averywallis/Feather-NEO-M9N-GPS/README.md

# Feather-NEO-M9N-GPS
 KiCad files for a NEO-M9N GPS Featherwing
