averywallis/Feather-NEO-M9N-GPS/Rev2.3/schematic-rev2.3.pdf

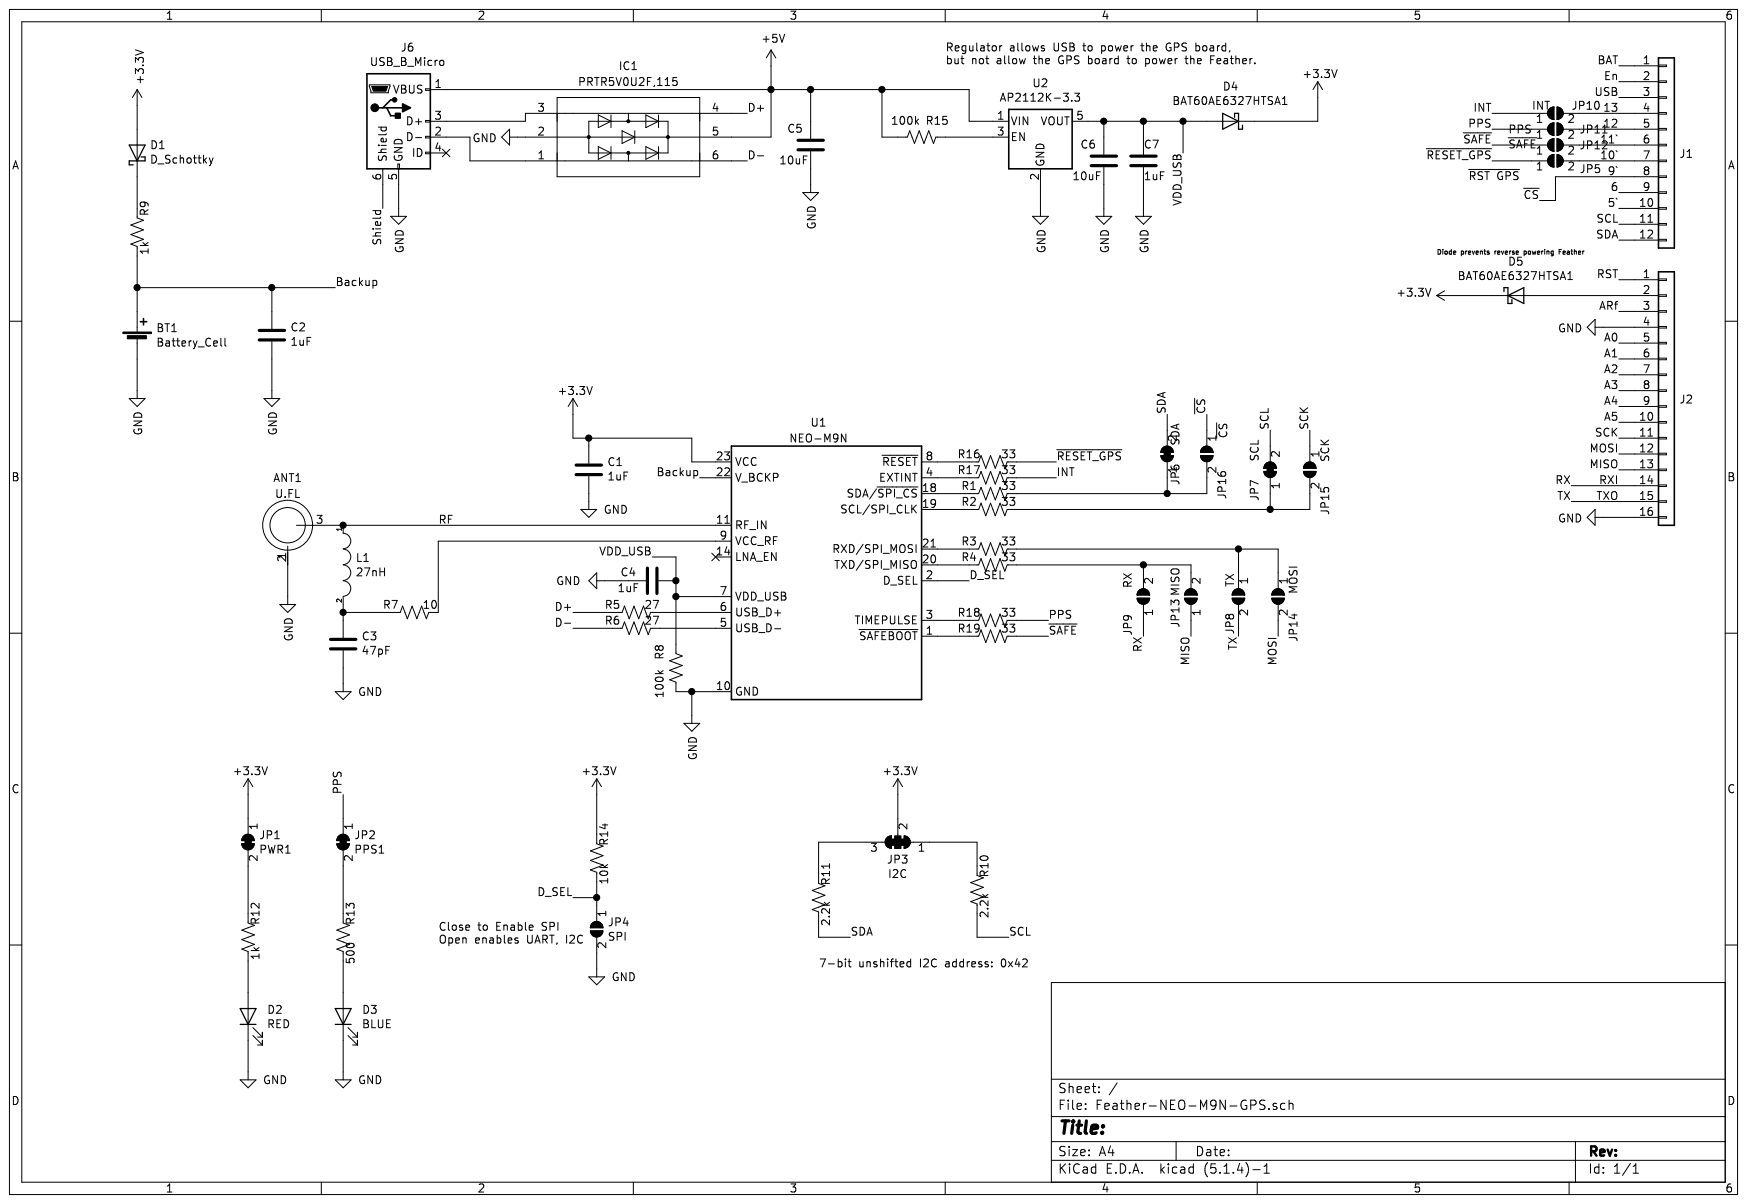
[picture p1: page 1]
