averywallis/Feather-NEO-M9N-GPS/Rev2.2/schematic.pdf

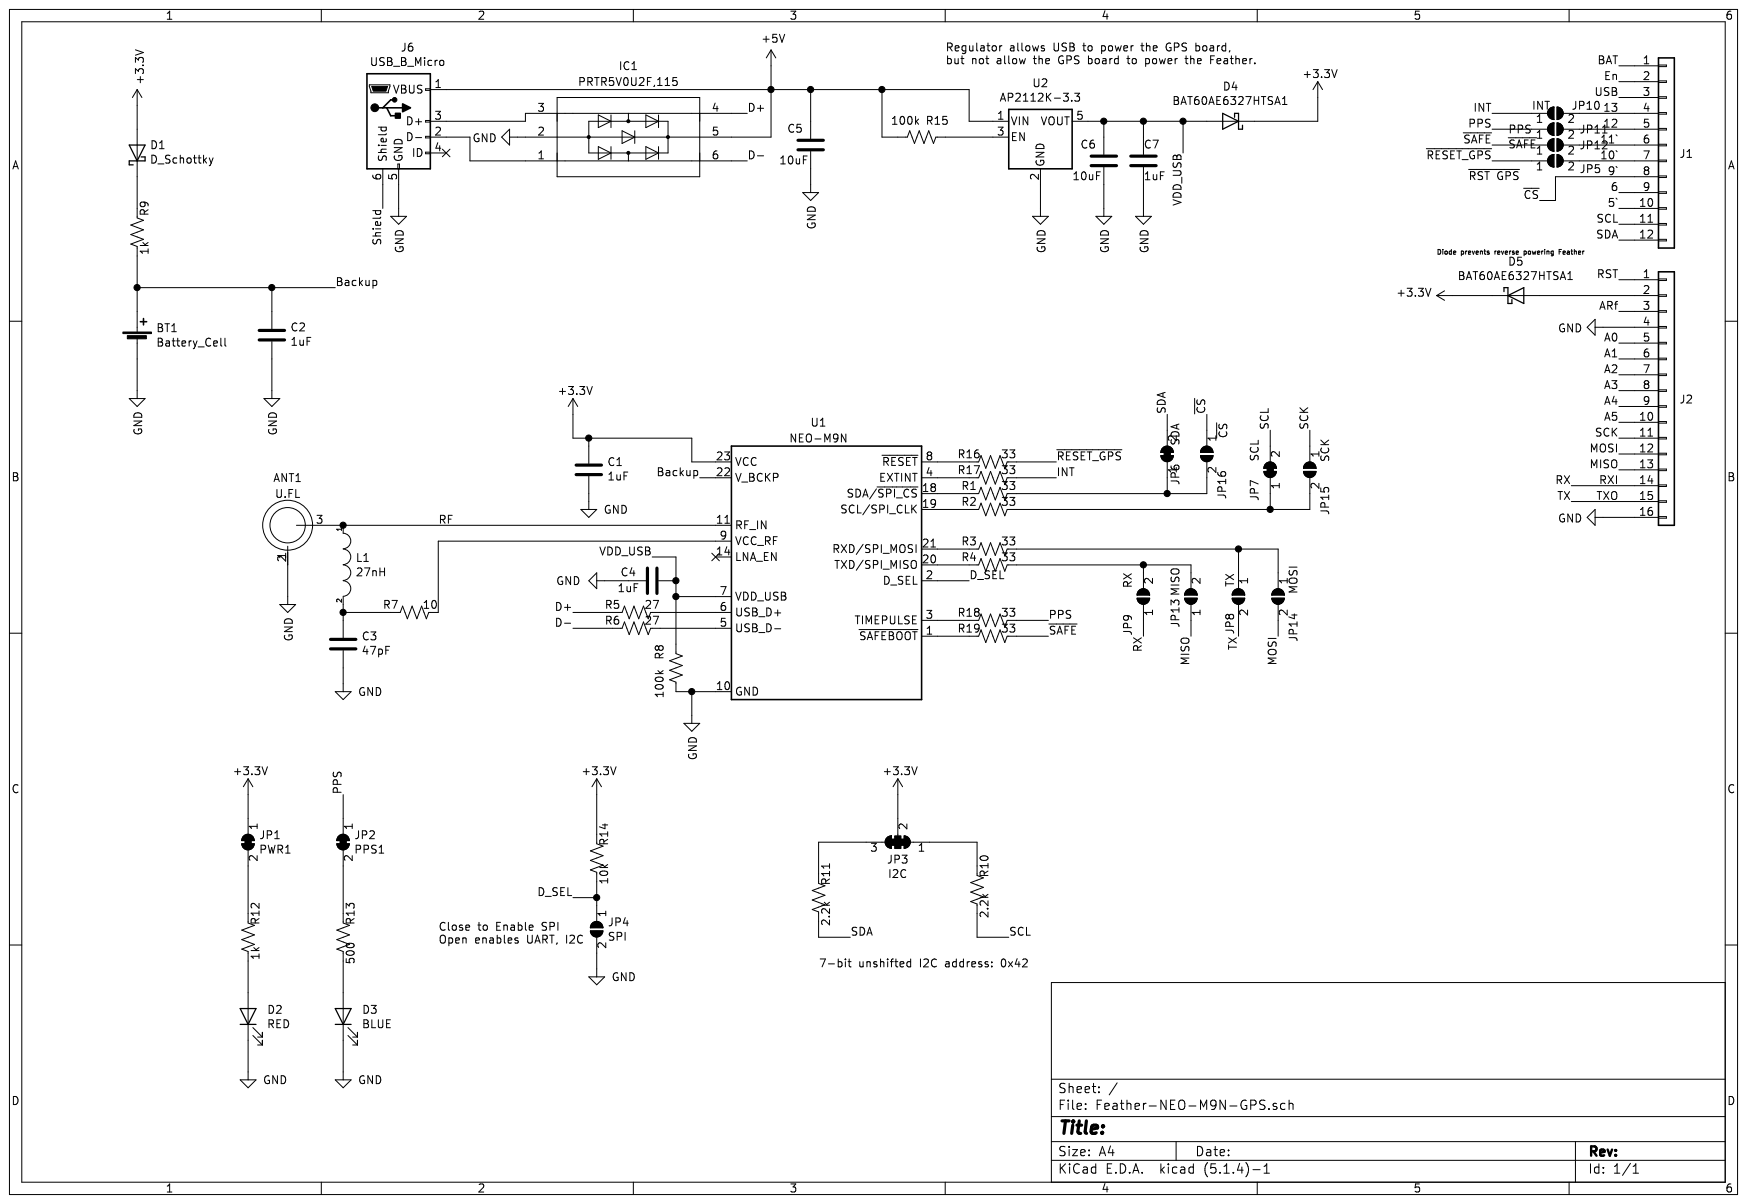
[picture p2: page 1]
