averywallis/Feather-NEO-M9N-GPS/Rev2/NEO-M9N-Rev2-Schematic.pdf

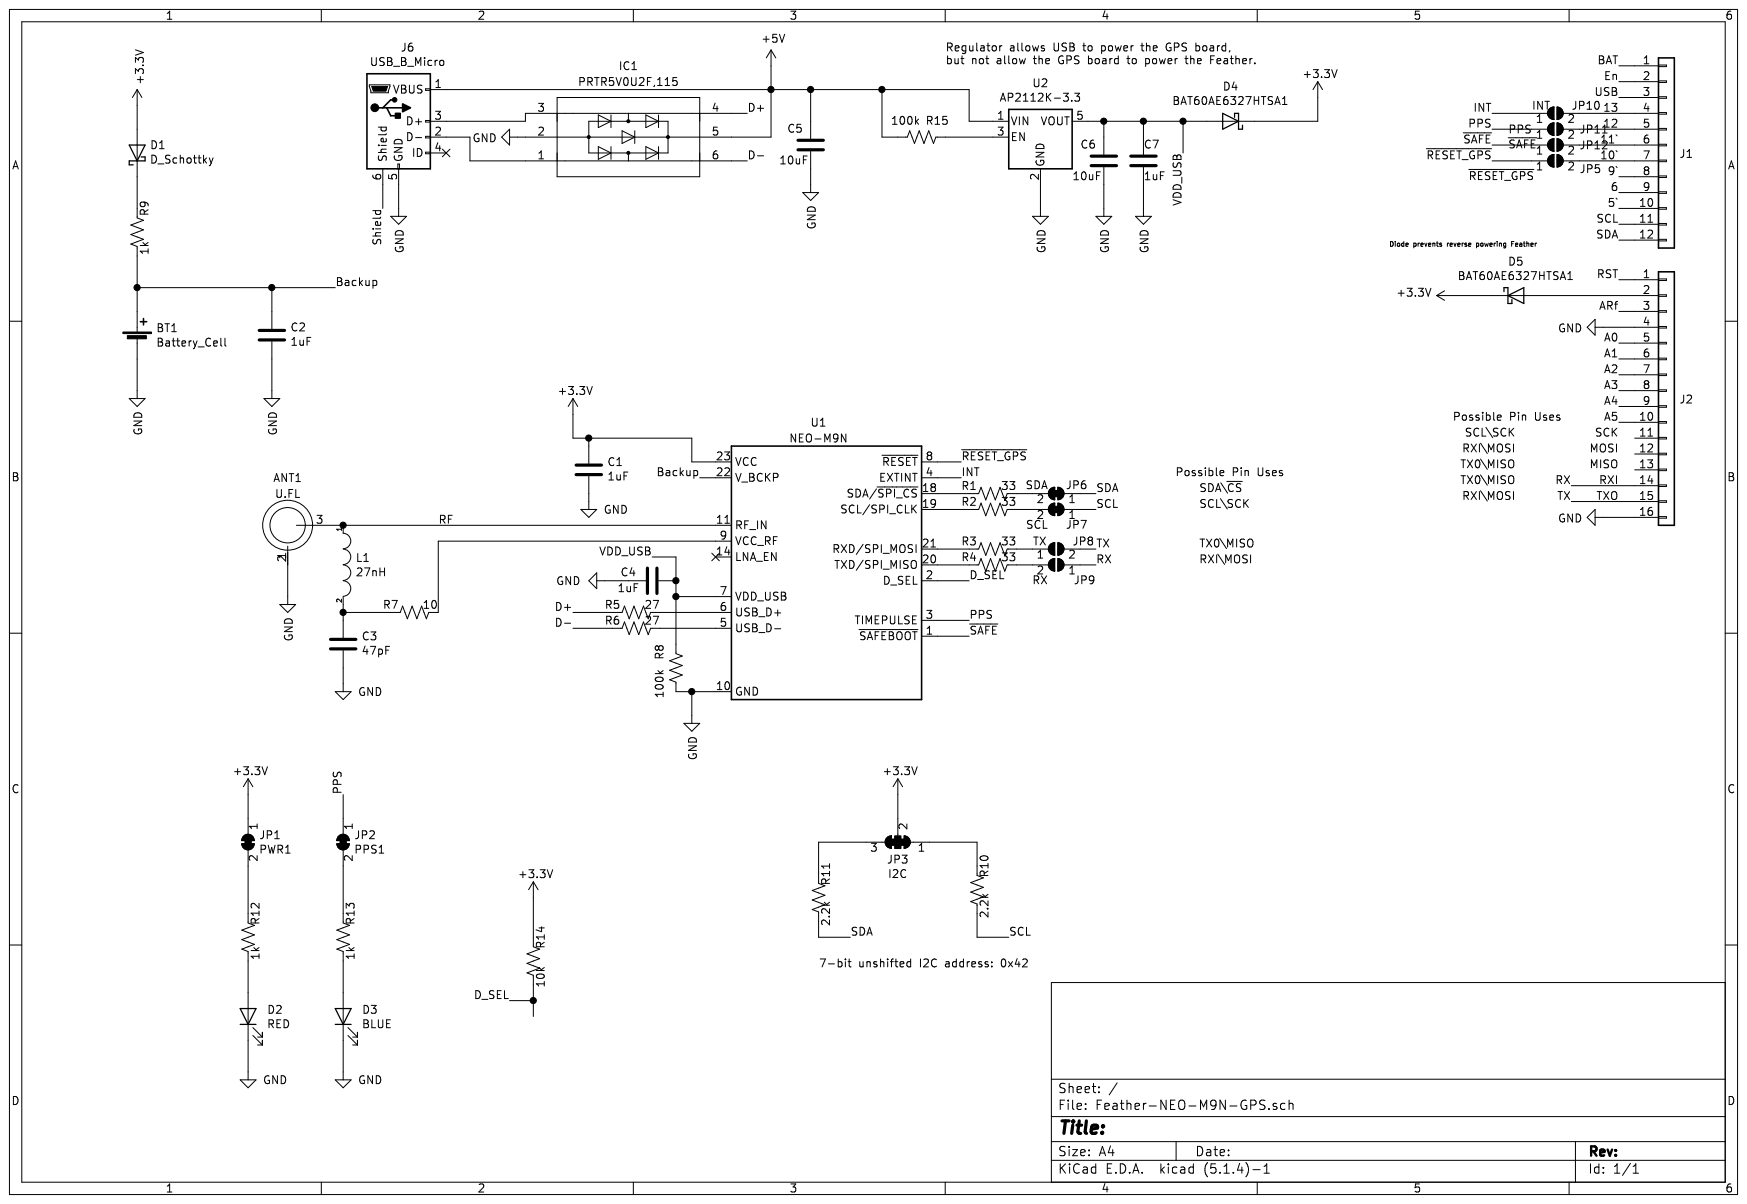
[picture p3: page 1]
