averywallis/Feather-NEO-M9N-GPS/Feather-NEO-M9N-GPS.kicad_pcb

## KiCad design Feather-NEO-M9N-GPS.kicad_pcb (2022-01-29)

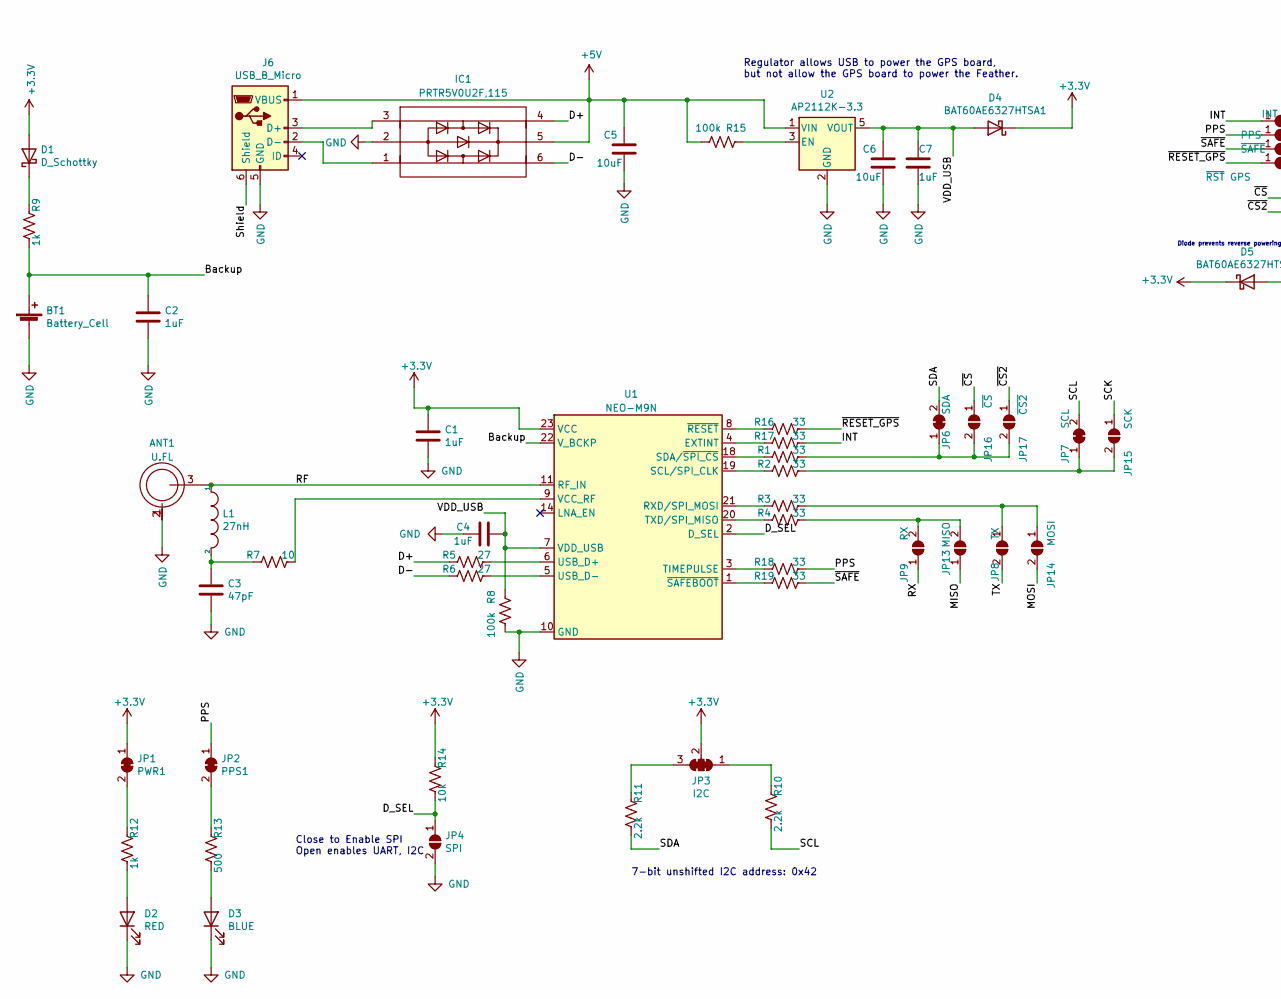
[picture p4: schematic Feather-NEO-M9N-GPS.sch, part in row 1, column 1]

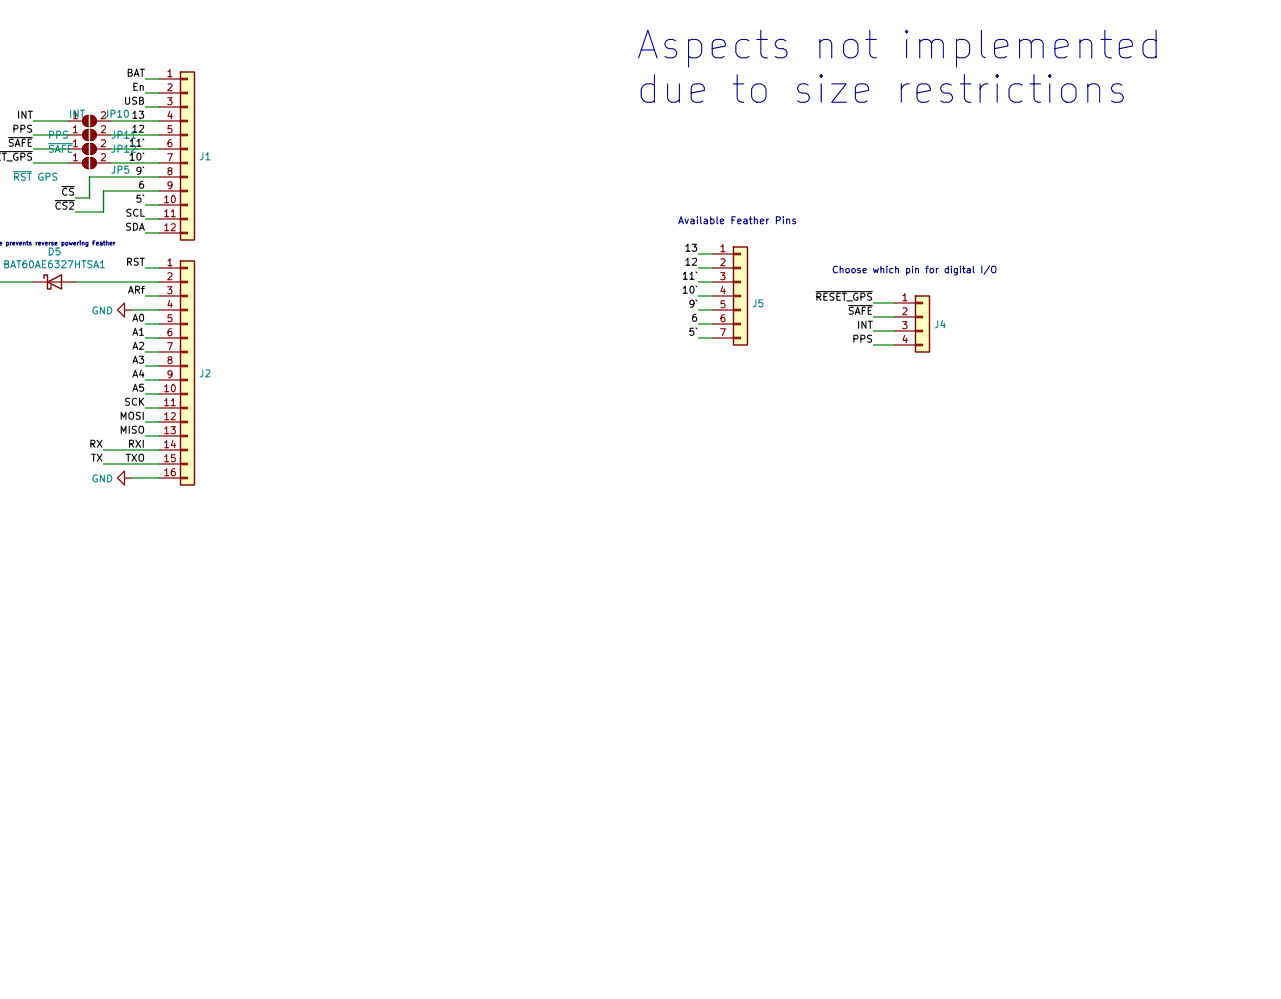
[picture p5: schematic Feather-NEO-M9N-GPS.sch, part in row 1, column 2]

Parts:
ANT1: U.FL; UFLRSMT10; MPN U.FL-R-SMT(10)
BT1: Battery_Cell; BatteryHolder_Seiko_MS621F; MPN MS621FE-FL11E
C1, C2, C4, C7: 1uF; C_0603_1608Metric; MPN CL10A105KA8NNNC
C3: 47pF; C_0603_1608Metric; MPN GRM1885C1H470FA01J
C5, C6: 10uF; C_0603_1608Metric; MPN GRM188R61C106KAALD
D1: D_Schottky; D_SOD-323F; MPN PMEG4005EJF
D2: RED; LED_0603_1608Metric; MPN SML-D12V8WT86
D3: BLUE; LED_0603_1608Metric; MPN 598-8091-107F
D4, D5: BAT60AE6327HTSA1; SOD2513X110N; MPN BAT60AE6327HTSA1
IC1: PRTR5V0U2F,115; 74LVC1G27GM115; MPN PRTR5V0U2F,115
J1: PinHeader_1x12_P2.54mm_Vertical
J2: PinHeader_1x16_P2.54mm_Vertical
J4: PinHeader_1x04_P2.54mm_Vertical
J5: PinHeader_1x07_P2.54mm_Vertical
J6: USB_B_Micro; USB_Micro-B_Molex_47346-0001; MPN 47346-0001
JP1: PWR1; SolderJumper-2_P1.3mm_Bridged_RoundedPad1.0x1.5mm
JP2: PPS1; SolderJumper-2_P1.3mm_Bridged_RoundedPad1.0x1.5mm
JP3: I2C; SMT-JUMPER_3_2-NC_TRACE_SILK
JP4: SPI; SolderJumper-2_P1.3mm_Open_RoundedPad1.0x1.5mm
JP5: ~RST GPS; SolderJumper-2_P1.3mm_Open_RoundedPad1.0x1.5mm
JP6: SDA; SolderJumper-2_P1.3mm_Bridged_RoundedPad1.0x1.5mm
JP7: SCL; SolderJumper-2_P1.3mm_Bridged_RoundedPad1.0x1.5mm
JP8: TX; SolderJumper-2_P1.3mm_Open_RoundedPad1.0x1.5mm
JP9: RX; SolderJumper-2_P1.3mm_Open_RoundedPad1.0x1.5mm
JP10: INT; SolderJumper-2_P1.3mm_Open_RoundedPad1.0x1.5mm
JP11: PPS; SolderJumper-2_P1.3mm_Open_RoundedPad1.0x1.5mm
JP12: ~SAFE; SolderJumper-2_P1.3mm_Open_RoundedPad1.0x1.5mm
JP13: MISO; SolderJumper-2_P1.3mm_Open_RoundedPad1.0x1.5mm
JP14: MOSI; SolderJumper-2_P1.3mm_Open_RoundedPad1.0x1.5mm
JP15: SCK; SolderJumper-2_P1.3mm_Open_RoundedPad1.0x1.5mm
JP16: ~CS; SolderJumper-2_P1.3mm_Open_RoundedPad1.0x1.5mm
JP17: ~CS2; SolderJumper-2_P1.3mm_Open_RoundedPad1.0x1.5mm
L1: 27nH; L_0805_2012Metric; MPN CE201210-27NJ
R1, R2, R3, R4, R16, R17, R18, R19: 33; R_0402_1005Metric; MPN ESR03EZPJ330
R5, R6: 27; R_0603_1608Metric; MPN ERJ-PA3F27R0V
R7: 10; R_0603_1608Metric; MPN ESR03EZPF10R0
R8, R15: 100k; R_0603_1608Metric; MPN ESR03EZPF1003
R9, R12: 1k; R_0603_1608Metric; MPN ESR03EZPJ102
R10, R11: 2.2k; R_0603_1608Metric; MPN ESR03EZPJ222
R13: 500; R_0603_1608Metric; MPN ESR03EZPJ102
R14: 10k; R_0603_1608Metric; MPN ESR03EZPJ103
U1: NEO-M9N
U2: AP2112K-3.3; SOT-23-5; MPN AP2112K-3.3TRG1

Connections:
+3V3: C1.2, D1.2 (A), D4.1 (K), D5.1 (K), JP1.1 (A), JP3.2 (C), R14.2, U1.23 (VCC)
+5V: C5.2, IC1.5, J6.1 (VBUS), R15.1, U2.1 (VIN)
/5`: J1.10, J5.7
/6: J1.9, J5.6, JP17.1 (A)
/9`: J1.8, J5.5, JP16.1 (A)
/10`: J1.7, J5.4, JP5.2 (B)
/11`: J1.6, J5.3, JP12.2 (B)
/12: J1.5, J5.2, JP11.2 (B)
/13: J1.4, J5.1, JP10.2 (B)
/A0: J2.5
/A1: J2.6
/A2: J2.7
/A3: J2.8
/A4: J2.9
/A5: J2.10
/ARf: J2.3
/BAT: J1.1
/Backup: BT1.1 (+), C2.2, R9.1, U1.22 (V_BCKP)
/D+: IC1.4, R5.2
/D-: IC1.6, R6.2
/D_SEL: JP4.1 (A), R14.1, U1.2 (D_SEL)
/En: J1.2
/INT: J4.3, JP10.1 (A), R17.1
/MISO: J2.13, JP13.1 (A)
/MOSI: J2.12, JP14.2 (B)
/PPS: J4.4, JP2.1 (A), JP11.1 (A), R18.1
/RF: ANT1.3, L1.1, U1.11 (RF_IN)
/RST: J2.1
/RX: J2.14, JP9.1 (A)
/SCK: J2.11, JP15.1 (A)
/SCL: J1.11, JP7.2 (B), R10.1
/SDA: J1.12, JP6.2 (B), R11.1
/Shield: J6.6 (Shield)
/TX: J2.15, JP8.2 (B)
/USB: J1.3
/VDD_USB: C4.2, C6.2, C7.2, D4.2 (A), R8.2, U1.7 (VDD_USB), U2.5 (VOUT)
/~RESET_GPS: J4.1, JP5.1 (A), R16.1
/~SAFE: J4.2, JP12.1 (A), R19.1
GND: ANT1.1, ANT1.2, BT1.2 (-), C1.1, C2.1, C3.1, C4.1, C5.1, C6.1, C7.1, D2.1 (K), D3.1 (K), IC1.2, J2.4, J2.16, J6.5 (GND), JP4.2 (B), R8.1, U1.10 (GND), U1.12 (GND), U1.13 (GND), U1.24 (GND), U2.2 (GND)
unnamed: C3.2, L1.2, R7.2
unnamed: D1.1 (K), R9.2
unnamed: D2.2 (A), R12.1
unnamed: D3.2 (A), R13.1
unnamed: D5.2 (A), J2.2
unnamed: IC1.1, J6.2 (D-)
unnamed: IC1.3, J6.3 (D+)
unnamed: JP1.2 (B), R12.2
unnamed: JP2.2 (B), R13.2
unnamed: JP3.1 (A), R10.2
unnamed: JP3.3 (B), R11.2
unnamed: JP9.2 (B), JP13.2 (B), R4.1
unnamed: JP8.1 (A), JP14.1 (A), R3.1
unnamed: JP7.1 (A), JP15.2 (B), R2.1
unnamed: JP6.1 (A), JP16.2 (B), JP17.2 (B), R1.1
unnamed: R1.2, U1.18 (SDA/~SPI_CS)
unnamed: R2.2, U1.19 (SCL/SPI_CLK)
unnamed: R3.2, U1.21 (RXD/SPI_MOSI)
unnamed: R4.2, U1.20 (TXD/SPI_MISO)
unnamed: R5.1, U1.6 (USB_D+)
unnamed: R6.1, U1.5 (USB_D-)
unnamed: R7.1, U1.9 (VCC_RF)
unnamed: R15.2, U2.3 (EN)
unnamed: R16.2, U1.8 (~RESET)
unnamed: R17.2, U1.4 (EXTINT)
unnamed: R18.2, U1.3 (TIMEPULSE)
unnamed: R19.2, U1.1 (~SAFEBOOT)

Notes on the sheet:
Close to Enable SPI Open enables UART, I2C
Available Feather Pins
Regulator allows USB to power the GPS board, but not allow the GPS board to power the Feather.
Diode prevents reverse powering Feather
7-bit unshifted I2C address: 0x42
Aspects not implemented due to size restrictions
Choose which pin for digital I/O

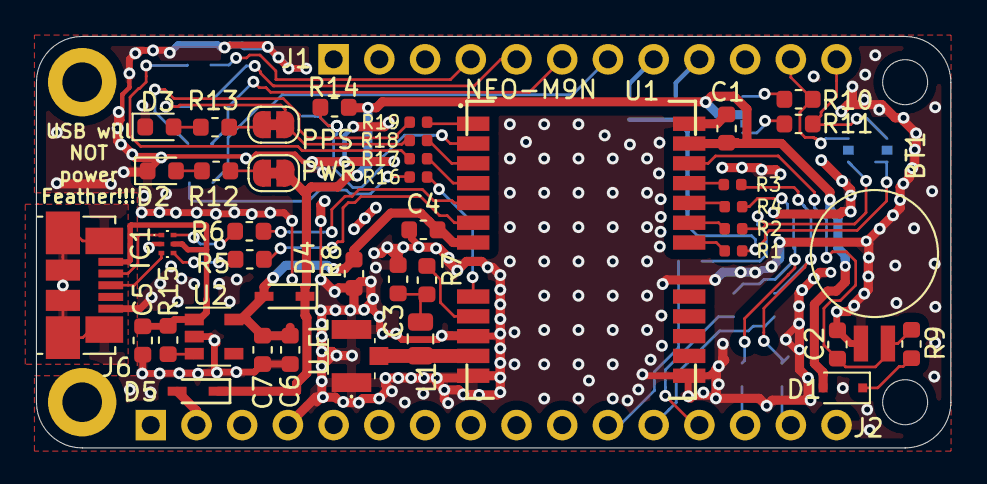
[picture p6: board Feather-NEO-M9N-GPS.kicad_pcb from above]

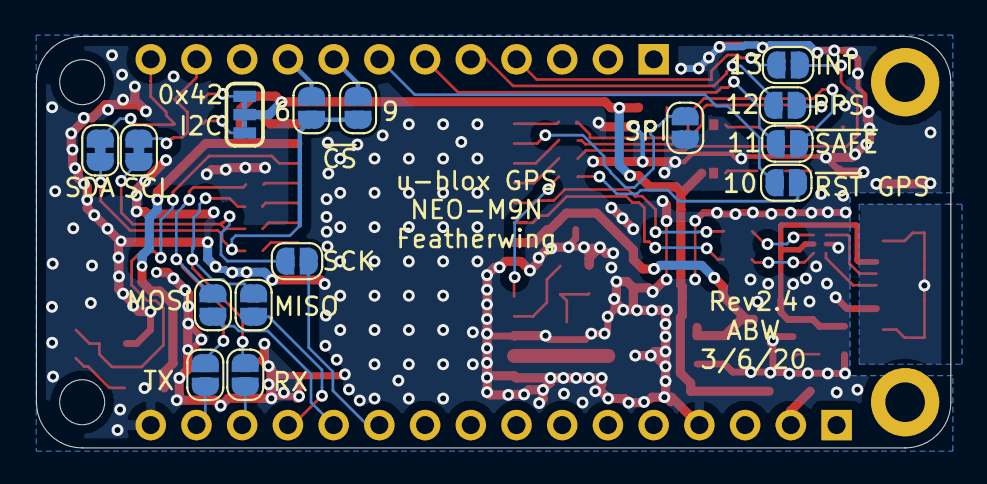
[picture p7: board Feather-NEO-M9N-GPS.kicad_pcb from below]

Board: 2 copper layers, 50.8 x 22.9 mm, 57 parts (15 on the bottom side), 53 nets.
