averywallis/Feather-NEO-M9N-GPS/Suggested Changes.txt

V2.4 Suggestions:
	Change USB connector to be through hole
	Fix front courtyards
