averywallis/Feather-NEO-M9N-GPS/(commit log)

2020-01-06 Rev2!
    Rev2 includes proper USB implementation, some small trace fixes, and power regulation
    [Feather-NEO-M9N-GPS-Rev1.kicad_pcb, Feather-NEO-M9N-GPS.kicad_pcb, Feather-NEO-M9N-GPS.sch]
2020-01-06 Added .GBR and images
    [Feather-NEO-M9N-GPS-B_Cu.gbr, Feather-NEO-M9N-GPS-B_Mask.gbr, Feather-NEO-M9N-GPS-B_Paste.gbr, Feather-NEO-M9N-GPS-B_SilkS.gbr, Feather-NEO-M9N-GPS-Dwgs_User.gbr, Feather-NEO-M9N-GPS-Edge_Cuts.gbr, Feather-NEO-M9N-GPS-F_Cu.gbr, Feather-NEO-M9N-GPS-F_Mask.gbr]
2020-01-06 Added KiCad file Archive of Rev2
2020-01-15 Added a pdf of the schematic for sharing
    [Feather-NEO-M9N-GPS.sch]
2020-01-24 Rev2.1 of NEO-M9N
    [Feather-NEO-M9N-GPS-B_Cu.gbr, Feather-NEO-M9N-GPS-B_Mask.gbr, Feather-NEO-M9N-GPS-B_Paste.gbr, Feather-NEO-M9N-GPS-B_SilkS.gbr, Feather-NEO-M9N-GPS-Dwgs_User.gbr, Feather-NEO-M9N-GPS-Edge_Cuts.gbr, Feather-NEO-M9N-GPS-F_Cu.gbr, Feather-NEO-M9N-GPS-F_Mask.gbr]
2020-02-01 Rev 2.2 designed
    Lots of great feedback from the u-blox team. Hopefully this revision fixes a lot of the problems they pointed out
    [Feather-NEO-M9N-GPS-B_Cu.gbr, Feather-NEO-M9N-GPS-B_Mask.gbr, Feather-NEO-M9N-GPS-B_Paste.gbr, Feather-NEO-M9N-GPS-B_SilkS.gbr, Feather-NEO-M9N-GPS-Dwgs_User.gbr, Feather-NEO-M9N-GPS-Edge_Cuts.gbr, Feather-NEO-M9N-GPS-F_Cu.gbr, Feather-NEO-M9N-GPS-F_Mask.gbr]
2020-02-26 Rev 2.3, u-blox approved!
    Rev 2.3 is finished! It has been approved by the design team at u-blox. Next step is to see if Adafruit would be interested in my continuing this design and possibly getting it onto their store if it works well enough
    [Feather-NEO-M9N-GPS-B_Cu.gbr, Feather-NEO-M9N-GPS-B_Mask.gbr, Feather-NEO-M9N-GPS-B_Paste.gbr, Feather-NEO-M9N-GPS-B_SilkS.gbr, Feather-NEO-M9N-GPS-Dwgs_User.gbr, Feather-NEO-M9N-GPS-Edge_Cuts.gbr, Feather-NEO-M9N-GPS-F_Cu.gbr, Feather-NEO-M9N-GPS-F_Mask.gbr]
2020-02-28 added photos, schematic, zip of files
    [Feather-NEO-M9N-GPS.sch]
2020-03-06 Added additional CS pin. Kept caps as is because of integration manual
    [Feather-NEO-M9N-GPS-B_Cu.gbr, Feather-NEO-M9N-GPS-B_Mask.gbr, Feather-NEO-M9N-GPS-B_Paste.gbr, Feather-NEO-M9N-GPS-B_SilkS.gbr, Feather-NEO-M9N-GPS-Dwgs_User.gbr, Feather-NEO-M9N-GPS-Edge_Cuts.gbr, Feather-NEO-M9N-GPS-F_Cu.gbr, Feather-NEO-M9N-GPS-F_Mask.gbr]
